M-J-Bauer/REMI-3-all-in-one-EWI/doc/REMI-3_proto1_dimensions.jpg

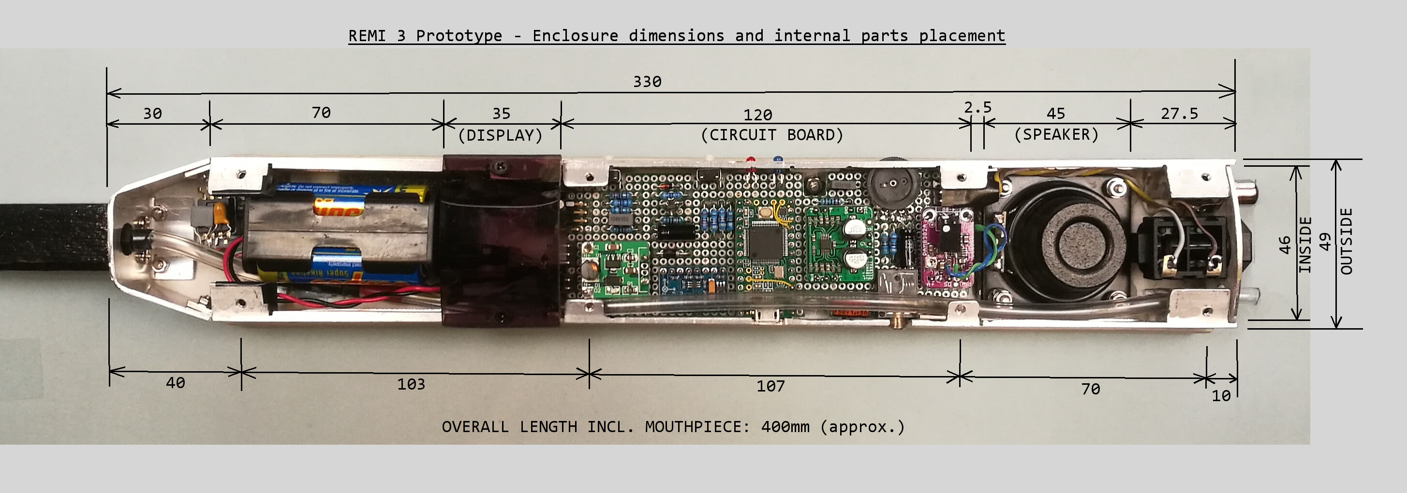
doc/REMI-3_proto1_dimensions.jpg
