M-J-Bauer/REMI-3-all-in-one-EWI/doc/REMI-3-cct-board-schematic-v1.1.pdf

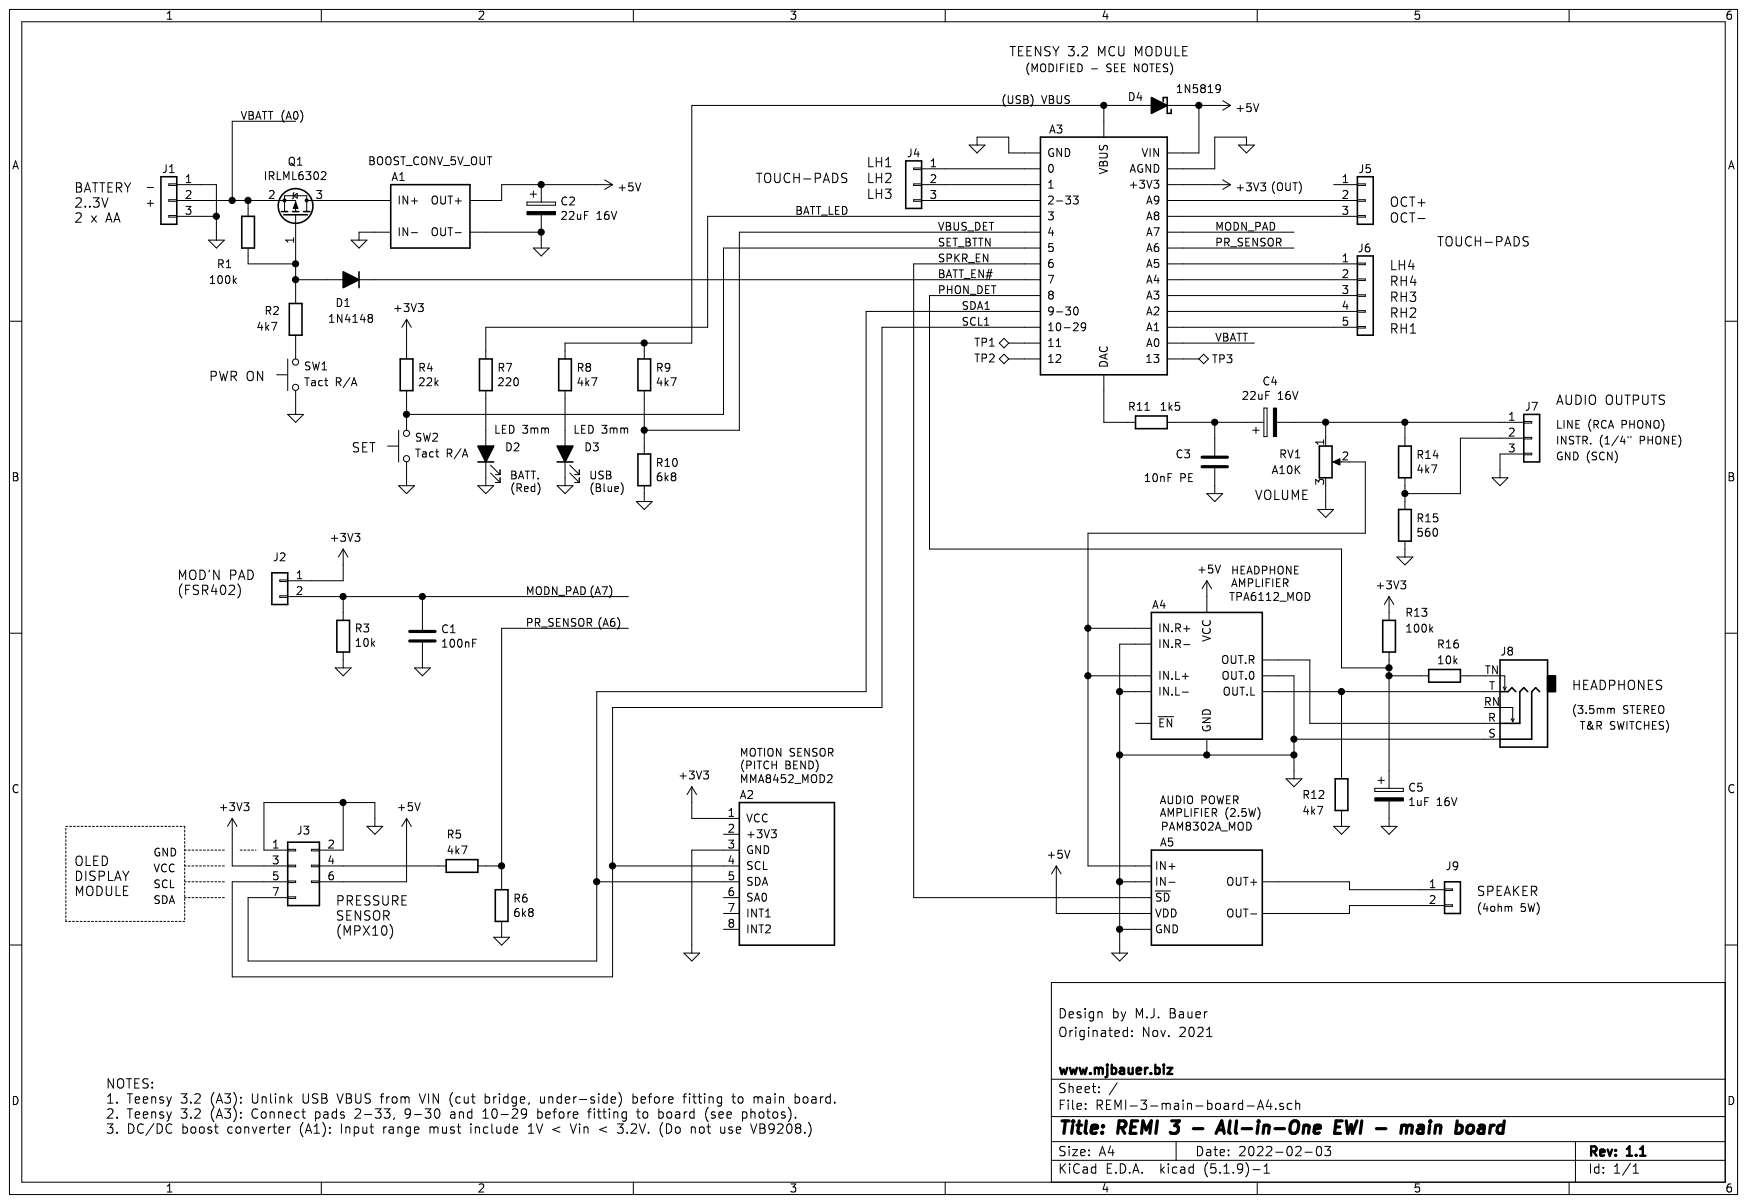
[picture p12: page 1]
