M-J-Bauer/REMI-3-all-in-one-EWI/remi_3_synth_data.ino

/*
 * Module:       remi_synth2_data.c
 *
 * Overview:     Patch parameter tables and waveform definitions.
 *
 * ================================================================================================
 */
#include "remi_3_synth.h"


// Pre-defined Patch "Programs" -- Array of patch parameter tables in flash memory
// ```````````````````````````````````````````````````````````````````````````````
const  PatchParamTable_t  g_PatchProgram[] =
{
    //--------  R E C O R D E R S,  F L U T E S   &   P I P E S  ---------
    {
        10,     // Patch ID Number
        "Recorder",
        13,     // W1: OSC1 Wave-table ID (0..99) = recorder_alto
        13,     // W2: OSC2 Wave-table ID (0..99) = recorder_alto
        0,      // OD: OSC2 Detune, cents (+/-1200)
        50,     // LF: LFO Freq x10 Hz (1..250)
        50,     // VD: Vibrato Depth, cents (0..200)
        500,    // VR: Vibrato Ramp time, (5..5000+ ms)

        0,      // MC: Mixer Control (0:Fixed, 1:Contour, 2:LFO, 3:Exprn, 4:Modn)
        0,      // ML: Mixer OSC2 Level in Fixed mode (0..100 %)
        0,      // CS: Contour Env Start level (0..100 %)
        0,      // CD: Contour Env Delay time (5..5000+ ms)
        200,    // CR: Contour Env Ramp time (5..5000+ ms)
        80,     // CH: Contour Env Hold level (0..100 %)
        
        0,      // NM: Noise Mode (0:Off, 1:Noise, 2:Add wave, 3:Mix wave; +4:Pitch)
        0,      // NC: Noise Level Ctrl (0:Fixed, 1:Ampld.Env, 2:LFO, 3:Exprn, 4:Modn)
        0,      // FC: Filter Control (0:Fixed, 1:Contour, 2:LFO, 3:Exprn, 4:Modn)
        0,      // FR: Filter Resonance x10000 (0..9990, 0:Bypass)
        0,      // FF: Filter Freq/Offset (semitone#, 0..108)
        0,      // FT: Filter Note Tracking (0:Off, 1:On)
                
        10,     // EA: Envelope Attack time (5..5000+ ms)
        0,      // EP: Envelope Peak time (0..5000+ ms)
        10,     // ED: Envelope Decay time (5..5000+ ms)
        100,    // ER: Envelope Release time (5..5000+ ms)
        90,     // ES: Envelope Sustain level (0..100 %)
        100,    // AL: Audio Level Adjust (10..250 %)
    },
    
    {
        11,     // Patch ID Number
        "Recorder celeste",
        2,      // W1: OSC1 Wave-table ID (0..99) = square_wave
        13,     // W2: OSC2 Wave-table ID (0..99) = recorder_alto
        -3,     // OD: OSC2 Detune, cents (+/-1200)
        50,     // LF: LFO Freq x10 Hz (1..250)
        20,     // VD: Vibrato Depth, cents (0..200)
        500,    // VR: Vibrato Ramp time, (5..5000+ ms)

        0,      // MC: Mixer Control (0:Fixed, 1:Contour, 2:LFO, 3:Exprn, 4:Modn)
        30,     // ML: Mixer OSC2 Level in Fixed mode (0..100 %)
        0,      // CS: Contour Env Start level (0..100 %)
        0,      // CD: Contour Env Delay time (5..5000+ ms)
        200,    // CR: Contour Env Ramp time (5..5000+ ms)
        80,     // CH: Contour Env Hold level (0..100 %)
        
        0,      // NM: Noise Mode (0:Off, 1:Noise, 2:Add wave, 3:Mix wave; +4:Pitch)
        0,      // NC: Noise Level Ctrl (0:Fixed, 1:Ampld.Env, 2:LFO, 3:Exprn, 4:Modn)
        0,      // FC: Filter Control (0:Fixed, 1:Contour, 2:LFO, 3:Exprn, 4:Modn)
        0,      // FR: Filter Resonance x10000 (0..9990, 0:Bypass)
        0,      // FF: Filter Freq/Offset (semitone#, 0..108)
        0,      // FT: Filter Note Tracking (0:Off, 1:On)
                
        10,     // EA: Envelope Attack time (5..5000+ ms)
        0,      // EP: Envelope Peak time (0..5000+ ms)
        10,     // ED: Envelope Decay time (5..5000+ ms)
        100,    // ER: Envelope Release time (5..5000+ ms)
        90,     // ES: Envelope Sustain level (0..100 %)
        100,    // AL: Audio Level Adjust (10..250 %)
    },    

    {
        12,     // Patch ID Number
        "Clean Bright Flute",
        6,      // W1: OSC1 Wave-table ID (0..99)
        6,      // W2: OSC2 Wave-table ID (0..99)
        0,      // OD: OSC2 Detune, cents (+/-1200)
        50,     // LF: LFO Freq x10 Hz (1..250)
        50,     // VD: Vibrato Depth, cents (0..200)
        500,    // VR: Vibrato Ramp time, (5..5000+ ms)

        0,      // MC: Mixer Control (0:Fixed, 1:Contour, 2:LFO, 3:Exprn, 4:Modn)
        0,      // ML: Mixer OSC2 Level in Fixed mode (0..100 %)
        0,      // CS: Contour Env Start level (0..100 %)
        0,      // CD: Contour Env Delay time (5..5000+ ms)
        200,    // CR: Contour Env Ramp time (5..5000+ ms)
        80,     // CH: Contour Env Hold level (0..100 %)
        
        0,      // NM: Noise Mode (0:Off, 1:Noise, 2:Add wave, 3:Mix wave; +4:Pitch)
        0,      // NC: Noise Level Ctrl (0:Fixed, 1:Ampld.Env, 2:LFO, 3:Exprn, 4:Modn)
        0,      // FC: Filter Control (0:Fixed, 1:Contour, 2:LFO, 3:Exprn, 4:Modn)
        0,      // FR: Filter Resonance x10000 (0..9990, 0:Bypass)
        0,      // FF: Filter Freq/Offset (semitone#, 0..108)
        0,      // FT: Filter Note Tracking (0:Off, 1:On)
                
        10,     // EA: Envelope Attack time (5..5000+ ms)
        0,      // EP: Envelope Peak time (0..5000+ ms)
        10,     // ED: Envelope Decay time (5..5000+ ms)
        100,    // ER: Envelope Release time (5..5000+ ms)
        90,     // ES: Envelope Sustain level (0..100 %)
        100,    // AL: Audio Level Adjust (10..250 %)
    },
    
    {
        13,     // Patch ID Number
        "Mellow Pipe",
        12,     // W1: OSC1 Wave-table ID (0..99)
        12,     // W2: OSC2 Wave-table ID (0..99)
        -3,     // OD: OSC2 Detune, cents (+/-1200)
        50,     // LF: LFO Freq x10 Hz (1..250)
        30,     // VD: Vibrato Depth, cents (0..200)
        500,    // VR: Vibrato Ramp time, (5..5000+ ms)

        0,      // MC: Mixer Control (0:Fixed, 1:Contour, 2:LFO, 3:Exprn, 4:Modn)
        20,     // ML: Mixer OSC2 Level in Fixed mode (0..100 %)
        0,      // CS: Contour Env Start level (0..100 %)
        0,      // CD: Contour Env Delay time (5..5000+ ms)
        200,    // CR: Contour Env Ramp time (5..5000+ ms)
        80,     // CH: Contour Env Hold level (0..100 %)
        
        0,      // NM: Noise Mode (0:Off, 1:Noise, 2:Add wave, 3:Mix wave; +4:Pitch)
        0,      // NC: Noise Level Ctrl (0:Fixed, 1:Ampld.Env, 2:LFO, 3:Exprn, 4:Modn)
        0,      // FC: Filter Control (0:Fixed, 1:Contour, 2:LFO, 3:Exprn, 4:Modn)
        0,      // FR: Filter Resonance x10000 (0..9990, 0:Bypass)
        0,      // FF: Filter Freq/Offset (semitone#, 0..108)
        0,      // FT: Filter Note Tracking (0:Off, 1:On)
                
        10,     // EA: Envelope Attack time (5..5000+ ms)
        0,      // EP: Envelope Peak time (0..5000+ ms)
        10,     // ED: Envelope Decay time (5..5000+ ms)
        100,    // ER: Envelope Release time (5..5000+ ms)
        90,     // ES: Envelope Sustain level (0..100 %)
        100,    // AL: Audio Level Adjust (10..250 %)
    },

    //---------------  R E E D E D   W O O D W I N D S  --------------------
    {
        21,     // Patch ID Number
        "Reeded Woodwind",  // Breath-controlled wave morph... sax-like
        2,      // W1: OSC1 Wave-table ID (0..99)
        9,      // W2: OSC2 Wave-table ID (0..99)
        -3,     // OD: OSC2 Detune, cents (+/-1200)
        50,     // LF: LFO Freq x10 Hz (1..250)
        30,     // VD: Vibrato Depth, cents (0..200)
        500,    // VR: Vibrato Ramp time (5..5000+ ms)

        3,      // MC: Mixer Control (0:Fixed, 1:Contour, 2:LFO, 3:Exprn, 4:Modn)
        0,      // ML: Mixer OSC2 Level in Fixed mode (0..100 %)
        80,     // CS: Contour Env Start level (0..100 %)
        5,      // CD: Contour Env Delay time (5..5000+ ms)
        500,    // CR: Contour Env Ramp time (5..5000+ ms)
        50,     // CH: Contour Env Hold level (0..100 %)

        0,      // NM: Noise Mode (0:Off, 1:Noise, 2:Add wave, 3:Mix wave; +4:Pitch)
        0,      // NC: Noise Level Ctrl (0:Fixed, 1:Ampld.Env, 2:LFO, 3:Exprn, 4:Modn)
        0,      // FC: Filter Ctrl (0:Fixed, 1:Contour, 2:Env+, 3:Env-, 4:LFO, 5:Modn)
        9700,   // FR: Filter Resonance x10000  (0..9990, 0:Bypass)
        15,     // FF: Filter Freq/Offset (semitone#, 0..108)
        1,      // FT: Filter Note Tracking (0:Off, 1:On)

        20,     // EA: Envelope Attack time (5..5000+ ms)
        0,      // EP: Envelope Peak time (0..5000+ ms)
        10,     // ED: Envelope Decay time (5..5000+ ms)
        100,    // ER: Envelope Release time (5..5000+ ms)
        90,     // ES: Envelope Sustain level (0..100 %)
        100,    // AL: Audio Level Adjust (10..250 %)
    },
    
    {
        23,     // Patch ID Number
        "Saxophoney",  // Sounds too simple... Needs work !!!  ***********************************
        9,      // W1: OSC1 Wave-table ID (0..99)
        9,      // W2: OSC2 Wave-table ID (0..99)
        0,      // OD: OSC2 Detune, cents (+/-1200)
        50,     // LF: LFO Freq x10 Hz (1..250)
        30,     // VD: Vibrato Depth, cents (0..200)
        500,    // VR: Vibrato Ramp time, (5..5000+ ms)

        0,      // MC: Mixer Control (0:Fixed, 1:Contour, 2:LFO, 3:Exprn, 4:Modn)
        0,      // ML: Mixer OSC2 Level in Fixed mode (0..100 %)
        0,      // CS: Contour Env Start level (0..100 %)
        0,      // CD: Contour Env Delay time (5..5000+ ms)
        200,    // CR: Contour Env Ramp time (5..5000+ ms)
        80,     // CH: Contour Env Hold level (0..100 %)
        
        0,      // NM: Noise Mode (0:Off, 1:Noise, 2:Add wave, 3:Mix wave; +4:Pitch)
        0,      // NC: Noise Level Ctrl (0:Fixed, 1:Ampld.Env, 2:LFO, 3:Exprn, 4:Modn)
        0,      // FC: Filter Control (0:Fixed, 1:Contour, 2:LFO, 3:Exprn, 4:Modn)
        0,      // FR: Filter Resonance x10000 (0..9990, 0:Bypass)
        0,      // FF: Filter Freq/Offset (semitone#, 0..108)
        0,      // FT: Filter Note Tracking (0:Off, 1:On)
                
        20,     // EA: Envelope Attack time (5..5000+ ms)
        0,      // EP: Envelope Peak time (0..5000+ ms)
        10,     // ED: Envelope Decay time (5..5000+ ms)
        100,    // ER: Envelope Release time (5..5000+ ms)
        90,     // ES: Envelope Sustain level (0..100 %)
        100,    // AL: Audio Level Adjust (10..250 %)
    },

    {
        24,     // Patch ID Number
        "Mellow Reed",
        23,     // W1: OSC1 Wave-table ID (0..99)
        23,     // W2: OSC2 Wave-table ID (0..99)
        -3,     // OD: OSC2 Detune, cents (+/-1200)
        50,     // LF: LFO Freq x10 Hz (1..250)
        30,     // VD: Vibrato Depth, cents (0..200)
        500,    // VR: Vibrato Ramp time, (5..5000+ ms)

        0,      // MC: Mixer Control (0:Fixed, 1:Contour, 2:LFO, 3:Exprn, 4:Modn)
        20,     // ML: Mixer OSC2 Level in Fixed mode (0..100 %)
        0,      // CS: Contour Env Start level (0..100 %)
        0,      // CD: Contour Env Delay time (5..5000+ ms)
        200,    // CR: Contour Env Ramp time (5..5000+ ms)
        80,     // CH: Contour Env Hold level (0..100 %)
        
        0,      // NM: Noise Mode (0:Off, 1:Noise, 2:Add wave, 3:Mix wave; +4:Pitch)
        0,      // NC: Noise Level Ctrl (0:Fixed, 1:Ampld.Env, 2:LFO, 3:Exprn, 4:Modn)
        0,      // FC: Filter Control (0:Fixed, 1:Contour, 2:LFO, 3:Exprn, 4:Modn)
        0,      // FR: Filter Resonance x10000 (0..9990, 0:Bypass)
        0,      // FF: Filter Freq/Offset (semitone#, 0..108)
        0,      // FT: Filter Note Tracking (0:Off, 1:On)
                
        10,     // EA: Envelope Attack time (5..5000+ ms)
        0,      // EP: Envelope Peak time (0..5000+ ms)
        10,     // ED: Envelope Decay time (5..5000+ ms)
        100,    // ER: Envelope Release time (5..5000+ ms)
        90,     // ES: Envelope Sustain level (0..100 %)
        100,    // AL: Audio Level Adjust (10..250 %)
    },

    {
        25,     // Patch ID Number   
        "Psychedelic Oboe",
        9,      // W1: OSC1 Wave-table ID (0..99)
        10,     // W2: OSC2 Wave-table ID (0..99)
        -7,     // OD: OSC2 Detune, cents (+/-1200)
        50,     // LF: LFO Freq x10 Hz (1..250)
        30,     // VD: Vibrato Depth, cents (0..200)
        300,    // VR: Vibrato Ramp time, (5..5000+ ms)

        3,      // MC: Mixer Control (0:Fixed, 1:Contour, 2:LFO, 3:Exprn, 4:Modn)
        50,     // ML: Mixer OSC2 Level in Fixed mode (0..100 %)
        10,     // CS: Contour Env Start level (0..100 %)
        50,     // CD: Contour Env Delay time (5..5000+ ms)
        500,    // CR: Contour Env Ramp time (5..5000+ ms)
        80,     // CH: Contour Env Hold level (0..100 %)
        
        0,      // NM: Noise Mode (0:Off, 1:Noise, 2:Add wave, 3:Mix wave; +4:Pitch)
        0,      // NC: Noise Level Ctrl (0:Fixed, 1:Ampld.Env, 2:LFO, 3:Exprn, 4:Modn)
        0,      // FC: Filter Control (0:Fixed, 1:Contour, 2:LFO, 3:Exprn, 4:Modn)
        0,      // FR: Filter Resonance x10000 (0..9990, 0:Bypass)
        0,      // FF: Filter Freq/Offset (semitone#, 0..108)
        0,      // FT: Filter Note Tracking (0:Off, 1:On)
                
        20,     // EA: Envelope Attack time (5..5000+ ms)
        0,      // EP: Envelope Peak time (0..5000+ ms)
        10,     // ED: Envelope Decay time (5..5000+ ms)
        100,    // ER: Envelope Release time (5..5000+ ms)
        90,     // ES: Envelope Sustain level (0..100 %)
        100,    // AL: Audio Level Adjust (10..250 %)
    },

    {
        26,     // Patch ID Number  
        "Electric Clarinet",  
        12,     // W1: OSC1 Wave-table ID (0..99)
        11,     // W2: OSC2 Wave-table ID (0..99)
        3,      // OD: OSC2 Detune, cents (+/-1200)
        50,     // LF: LFO Freq x10 Hz (1..250)
        30,     // VD: Vibrato Depth, cents (0..200)
        500,    // VR: Vibrato Ramp time, (5..5000+ ms)

        3,      // MC: Mixer Control (0:Fixed, 1:Contour, 2:LFO, 3:Exprn, 4:Modn)
        50,     // ML: Mixer OSC2 Level in Fixed mode (0..100 %)
        0,      // CS: Contour Env Start level (0..100 %)
        0,      // CD: Contour Env Delay time (5..5000+ ms)
        200,    // CR: Contour Env Ramp time (5..5000+ ms)
        100,    // CH: Contour Env Hold level (0..100 %)
        
        0,      // NM: Noise Mode (0:Off, 1:Noise, 2:Add wave, 3:Mix wave; +4:Pitch)
        0,      // NC: Noise Level Ctrl (0:Fixed, 1:Ampld.Env, 2:LFO, 3:Exprn, 4:Modn)
        0,      // FC: Filter Control (0:Fixed, 1:Contour, 2:LFO, 3:Exprn, 4:Modn)
        9700,   // FR: Filter Resonance x10000 (0..9990, 0:Bypass)
        9,      // FF: Filter Freq/Offset (semitone#, 0..108)
        1,      // FT: Filter Note Tracking (0:Off, 1:On)
                
        20,     // EA: Envelope Attack time (5..5000+ ms)
        0,      // EP: Envelope Peak time (0..5000+ ms)
        10,     // ED: Envelope Decay time (5..5000+ ms)
        100,    // ER: Envelope Release time (5..5000+ ms)
        90,     // ES: Envelope Sustain level (0..100 %)
        100,    // AL: Audio Level Adjust (10..250 %)
    },
    
    //----------------  B O W E D   S T R I N G   I N S T R U M E N T S  ------------
    {
        30,     // Patch ID Number
        "Vinyl-cello",
        3,      // W1: OSC1 Wave-table ID (0..99) 
        3,      // W2: OSC2 Wave-table ID (0..99)   
        3,      // OD: OSC2 Detune, cents (+/-1200)
        50,     // LF: LFO Freq x10 Hz (1..250)
        30,     // VD: Vibrato Depth, cents (0..200)
        300,    // VR: Vibrato Ramp time, (5..5000+ ms)

        1,      // MC: Mixer Control (0:Fixed, 1:Contour, 2:LFO, 3:Exprn, 4:Modn)
        50,     // ML: Mixer OSC2 Level in Fixed mode (0..100 %)
        20,     // CS: Contour Env Start level (0..100 %)
        10,     // CD: Contour Env Delay time (5..5000+ ms)
        200,    // CR: Contour Env Ramp time (5..5000+ ms)
        80,     // CH: Contour Env Hold level (0..100 %)
        
        0,      // NM: Noise Mode (0:Off, 1:Noise, 2:Add wave, 3:Mix wave; +4:Pitch)
        0,      // NC: Noise Level Ctrl (0:Fixed, 1:Ampld.Env, 2:LFO, 3:Exprn, 4:Modn)
        0,      // FC: Filter Control (0:Fixed, 1:Contour, 2:LFO, 3:Exprn, 4:Modn)
        9500,   // FR: Filter Resonance x10000  (0..9990, 0:Bypass)
        60,     // FF: Filter Freq/Offset (semitone#, 0..108)
        0,      // FT: Filter Note Tracking (0:Off, 1:On)
                
        30,     // EA: Envelope Attack time (5..5000+ ms)
        0,      // EP: Envelope Peak time (0..5000+ ms)
        10,     // ED: Envelope Decay time (5..5000+ ms)
        10,     // ER: Envelope Release time (5..5000+ ms)
        90,     // ES: Envelope Sustain level (0..100 %)
        100,    // AL: Audio Level Adjust (10..250 %)
    },

    //------------------  O R G A N S   &  A C C O R D I O N  -----------------
    {
        40,     // Patch ID Number
        "Jazz Organ celeste",  // Experiment with wave-tables  **************************
        14,     // W1: OSC1 Wave-table ID (0..99) = jazz_organ_v1
        14,     // W2: OSC2 Wave-table ID (0..99) = jazz_organ_v1
        -6,     // OD: OSC2 Detune, cents (+/-1200)
        50,     // LF: LFO Freq x10 Hz (1..250)
        30,     // VD: Vibrato Depth, cents (0..200)
        500,    // VR: Vibrato Ramp time, (5..5000+ ms)

        0,      // MC: Mixer Control (0:Fixed, 1:Contour, 2:LFO, 3:Exprn, 4:Modn)
        30,     // ML: Mixer OSC2 Level in Fixed mode (0..100 %)
        0,      // CS: Contour Env Start level (0..100 %)
        0,      // CD: Contour Env Delay time (5..5000+ ms)
        200,    // CR: Contour Env Ramp time (5..5000+ ms)
        80,     // CH: Contour Env Hold level (0..100 %)
        
        0,      // NM: Noise Mode (0:Off, 1:Noise, 2:Add wave, 3:Mix wave; +4:Pitch)
        0,      // NC: Noise Level Ctrl (0:Fixed, 1:Ampld.Env, 2:LFO, 3:Exprn, 4:Modn)
        0,      // FC: Filter Control (0:Fixed, 1:Contour, 2:LFO, 3:Exprn, 4:Modn)
        0,      // FR: Filter Resonance x10000 (0..9990, 0:Bypass)
        0,      // FF: Filter Freq/Offset (semitone#, 0..108)
        0,      // FT: Filter Note Tracking (0:Off, 1:On)
                
        5,      // EA: Envelope Attack time (5..5000+ ms)
        0,      // EP: Envelope Peak time (0..5000+ ms)
        5,      // ED: Envelope Decay time (5..5000+ ms)
        10,     // ER: Envelope Release time (5..5000+ ms)
        80,     // ES: Envelope Sustain level (0..100 %)
        100,    // AL: Audio Level Adjust (10..250 %)
    },
    
    {
        41,     // Patch ID Number
        "Jazz-Rock Organ 1",  // Classic Hammond rock organ tone.  Slightly percussive.
        17,     // W1: OSC1 Wave-table ID (0..99)   
        17,     // W2: OSC2 Wave-table ID (0..99) 
        0,      // OD: OSC2 Detune, cents (+/-1200)
        70,     // LF: LFO Freq x10 Hz (1..250)
        30,     // VD: Vibrato Depth, cents (0..200)
        500,    // VR: Vibrato Ramp time, (5..5000+ ms)

        0,      // MC: Mixer Control (0:Fixed, 1:Contour, 2:LFO, 3:Exprn, 4:Modn)
        50,     // ML: Mixer OSC2 Level in Fixed mode (0..100 %)
        0,      // CS: Contour Env Start level (0..100 %)
        0,      // CD: Contour Env Delay time (5..5000+ ms)
        200,    // CR: Contour Env Ramp time (5..5000+ ms)
        80,     // CH: Contour Env Hold level (0..100 %)
        
        0,      // NM: Noise Mode (0:Off, 1:Noise, 2:Add wave, 3:Mix wave; +4:Pitch)
        0,      // NC: Noise Level Ctrl (0:Fixed, 1:Ampld.Env, 2:LFO, 3:Exprn, 4:Modn)
        0,      // FC: Filter Control (0:Fixed, 1:Contour, 2:LFO, 3:Exprn, 4:Modn)
        0,      // FR: Filter Resonance x10000 (0..9990, 0:Bypass)
        0,      // FF: Filter Freq/Offset (semitone#, 0..108)
        0,      // FT: Filter Note Tracking (0:Off, 1:On)
                
        5,      // EA: Envelope Attack time (5..5000+ ms)
        50,     // EP: Envelope Peak time (0..5000+ ms)
        100,    // ED: Envelope Decay time (5..5000+ ms)
        50,     // ER: Envelope Release time (5..5000+ ms)
        70,     // ES: Envelope Sustain level (0..100 %)
        100,    // AL: Audio Level Adjust (10..250 %)
    },

    {
        42,     // Patch ID Number
        "Jazz-Rock Organ 2",  // Classic Hammond rock organ tone.  Slightly percussive.
        18,     // W1: OSC1 Wave-table ID (0..99)   
        18,     // W2: OSC2 Wave-table ID (0..99)   
        0,      // OD: OSC2 Detune, cents (+/-1200)
        70,     // LF: LFO Freq x10 Hz (1..250)
        30,     // VD: Vibrato Depth, cents (0..200)
        500,    // VR: Vibrato Ramp time, (5..5000+ ms)

        0,      // MC: Mixer Control (0:Fixed, 1:Contour, 2:LFO, 3:Exprn, 4:Modn)
        25,     // ML: Mixer OSC2 Level in Fixed mode (0..100 %)
        0,      // CS: Contour Env Start level (0..100 %)
        0,      // CD: Contour Env Delay time (5..5000+ ms)
        200,    // CR: Contour Env Ramp time (5..5000+ ms)
        80,     // CH: Contour Env Hold level (0..100 %)
        
        0,      // NM: Noise Mode (0:Off, 1:Noise, 2:Add wave, 3:Mix wave; +4:Pitch)
        0,      // NC: Noise Level Ctrl (0:Fixed, 1:Ampld.Env, 2:LFO, 3:Exprn, 4:Modn)
        0,      // FC: Filter Control (0:Fixed, 1:Contour, 2:LFO, 3:Exprn, 4:Modn)
        0,      // FR: Filter Resonance x10000 (0..9990, 0:Bypass)
        0,      // FF: Filter Freq/Offset (semitone#, 0..108)
        0,      // FT: Filter Note Tracking (0:Off, 1:On)
                
        5,      // EA: Envelope Attack time (5..5000+ ms)
        50,     // EP: Envelope Peak time (0..5000+ ms)
        100,    // ED: Envelope Decay time (5..5000+ ms)
        50,     // ER: Envelope Release time (5..5000+ ms)
        70,     // ES: Envelope Sustain level (0..100 %)
        100,    // AL: Audio Level Adjust (10..250 %)
    },
    
    {
        43,     // Patch ID Number
        "Jazz-Rock Organ 3",  // Classic Hammond rock organ tone.  Slightly percussive.
        14,     // W1: OSC1 Wave-table ID (0..99)   
        14,     // W2: OSC2 Wave-table ID (0..99)   
        -5,     // OD: OSC2 Detune, cents (+/-1200)
        70,     // LF: LFO Freq x10 Hz (1..250)
        30,     // VD: Vibrato Depth, cents (0..200)
        500,    // VR: Vibrato Ramp time, (5..5000+ ms)

        0,      // MC: Mixer Control (0:Fixed, 1:Contour, 2:LFO, 3:Exprn, 4:Modn)
        25,     // ML: Mixer OSC2 Level in Fixed mode (0..100 %)
        0,      // CS: Contour Env Start level (0..100 %)
        0,      // CD: Contour Env Delay time (5..5000+ ms)
        200,    // CR: Contour Env Ramp time (5..5000+ ms)
        80,     // CH: Contour Env Hold level (0..100 %)
        
        0,      // NM: Noise Mode (0:Off, 1:Noise, 2:Add wave, 3:Mix wave; +4:Pitch)
        0,      // NC: Noise Level Ctrl (0:Fixed, 1:Ampld.Env, 2:LFO, 3:Exprn, 4:Modn)
        0,      // FC: Filter Control (0:Fixed, 1:Contour, 2:LFO, 3:Exprn, 4:Modn)
        0,      // FR: Filter Resonance x10000 (0..9990, 0:Bypass)
        0,      // FF: Filter Freq/Offset (semitone#, 0..108)
        0,      // FT: Filter Note Tracking (0:Off, 1:On)
                
        5,      // EA: Envelope Attack time (5..5000+ ms)
        50,     // EP: Envelope Peak time (0..5000+ ms)
        100,    // ED: Envelope Decay time (5..5000+ ms)
        50,     // ER: Envelope Release time (5..5000+ ms)
        70,     // ES: Envelope Sustain level (0..100 %)
        100,    // AL: Audio Level Adjust (10..250 %)
    },
    
    {
        44,     // Patch ID Number
        "Theatre Organ",  // "All stops out" -- rich & deep harmonic content
        21,     // W1: OSC1 Wave-table ID (0..99)   
        21,     // W2: OSC2 Wave-table ID (0..99)   
        -5,     // OD: OSC2 Detune, cents (+/-1200)
        70,     // LF: LFO Freq x10 Hz (1..250)
        30,     // VD: Vibrato Depth, cents (0..200)
        500,    // VR: Vibrato Ramp time, (5..5000+ ms)

        0,      // MC: Mixer Control (0:Fixed, 1:Contour, 2:LFO, 3:Exprn, 4:Modn)
        20,     // ML: Mixer OSC2 Level in Fixed mode (0..100 %)
        0,      // CS: Contour Env Start level (0..100 %)
        0,      // CD: Contour Env Delay time (5..5000+ ms)
        200,    // CR: Contour Env Ramp time (5..5000+ ms)
        80,     // CH: Contour Env Hold level (0..100 %)
        
        0,      // NM: Noise Mode (0:Off, 1:Noise, 2:Add wave, 3:Mix wave; +4:Pitch)
        0,      // NC: Noise Level Ctrl (0:Fixed, 1:Ampld.Env, 2:LFO, 3:Exprn, 4:Modn)
        0,      // FC: Filter Control (0:Fixed, 1:Contour, 2:LFO, 3:Exprn, 4:Modn)
        0,      // FR: Filter Resonance x10000 (0..9990, 0:Bypass)
        0,      // FF: Filter Freq/Offset (semitone#, 0..108)
        0,      // FT: Filter Note Tracking (0:Off, 1:On)
                
        5,      // EA: Envelope Attack time (5..5000+ ms)
        0,      // EP: Envelope Peak time (0..5000+ ms)
        5,      // ED: Envelope Decay time (5..5000+ ms)
        10,     // ER: Envelope Release time (5..5000+ ms)
        90,     // ES: Envelope Sustain level (0..100 %)
        100,    // AL: Audio Level Adjust (10..250 %)
    },
    
    {
        45,     // Patch ID Number
        "Pink Floyd Organ",  // Essential Preset Patch! -- complex etherial flutey tone
        20,     // W1: OSC1 Wave-table ID (0..99)   
        20,     // W2: OSC2 Wave-table ID (0..99)   
        -5,     // OD: OSC2 Detune, cents (+/-1200)
        70,     // LF: LFO Freq x10 Hz (1..250)
        30,     // VD: Vibrato Depth, cents (0..200)
        500,    // VR: Vibrato Ramp time, (5..5000+ ms)

        0,      // MC: Mixer Control (0:Fixed, 1:Contour, 2:LFO, 3:Exprn, 4:Modn)
        50,     // ML: Mixer OSC2 Level in Fixed mode (0..100 %)
        0,      // CS: Contour Env Start level (0..100 %)
        0,      // CD: Contour Env Delay time (5..5000+ ms)
        200,    // CR: Contour Env Ramp time (5..5000+ ms)
        80,     // CH: Contour Env Hold level (0..100 %)
        
        0,      // NM: Noise Mode (0:Off, 1:Noise, 2:Add wave, 3:Mix wave; +4:Pitch)
        0,      // NC: Noise Level Ctrl (0:Fixed, 1:Ampld.Env, 2:LFO, 3:Exprn, 4:Modn)
        0,      // FC: Filter Control (0:Fixed, 1:Contour, 2:LFO, 3:Exprn, 4:Modn)
        0,      // FR: Filter Resonance x10000 (0..9990, 0:Bypass)
        0,      // FF: Filter Freq/Offset (semitone#, 0..108)
        0,      // FT: Filter Note Tracking (0:Off, 1:On)
                
        10,     // EA: Envelope Attack time (5..5000+ ms)
        50,     // EP: Envelope Peak time (0..5000+ ms)
        100,    // ED: Envelope Decay time (5..5000+ ms)
        10,     // ER: Envelope Release time (5..5000+ ms)
        70,     // ES: Envelope Sustain level (0..100 %)
        100,    // AL: Audio Level Adjust (10..250 %)
    },
    
    {
        46,     // Patch ID Number
        "Bauer Organ",  // Bright, rich tone  (experiment with detune, contour, etc)
        22,     // W1: OSC1 Wave-table ID (0..99)   
        23,     // W2: OSC2 Wave-table ID (0..99) -- experiment with morph  *************
        7,      // OD: OSC2 Detune, cents (+/-1200)
        70,     // LF: LFO Freq x10 Hz (1..250)
        30,     // VD: Vibrato Depth, cents (0..200)
        500,    // VR: Vibrato Ramp time, (5..5000+ ms)

        3,      // MC: Mixer Control (0:Fixed, 1:Contour, 2:LFO, 3:Exprn, 4:Modn)
        20,     // ML: Mixer OSC2 Level in Fixed mode (0..100 %)
        0,      // CS: Contour Env Start level (0..100 %)
        0,      // CD: Contour Env Delay time (5..5000+ ms)
        200,    // CR: Contour Env Ramp time (5..5000+ ms)
        80,     // CH: Contour Env Hold level (0..100 %)
        
        0,      // NM: Noise Mode (0:Off, 1:Noise, 2:Add wave, 3:Mix wave; +4:Pitch)
        0,      // NC: Noise Level Ctrl (0:Fixed, 1:Ampld.Env, 2:LFO, 3:Exprn, 4:Modn)
        0,      // FC: Filter Control (0:Fixed, 1:Contour, 2:LFO, 3:Exprn, 4:Modn)
        0,      // FR: Filter Resonance x10000 (0..9990, 0:Bypass)
        0,      // FF: Filter Freq/Offset (semitone#, 0..108)
        0,      // FT: Filter Note Tracking (0:Off, 1:On)
                
        10,     // EA: Envelope Attack time (5..5000+ ms)
        50,     // EP: Envelope Peak time (0..5000+ ms)
        100,    // ED: Envelope Decay time (5..5000+ ms)
        10,     // ER: Envelope Release time (5..5000+ ms)
        70,     // ES: Envelope Sustain level (0..100 %)
        100,    // AL: Audio Level Adjust (10..250 %)
    },
    
    {
        47,     // Patch ID Number
        "Hammond Organ 1",  // Classic Hammond organ tone.  Slightly percussive.
        15,     // W1: OSC1 Wave-table ID (0..99)   
        15,     // W2: OSC2 Wave-table ID (0..99)   
        -5,     // OD: OSC2 Detune, cents (+/-1200)
        70,     // LF: LFO Freq x10 Hz (1..250)
        30,     // VD: Vibrato Depth, cents (0..200)
        500,    // VR: Vibrato Ramp time, (5..5000+ ms)

        0,      // MC: Mixer Control (0:Fixed, 1:Contour, 2:LFO, 3:Exprn, 4:Modn)
        25,     // ML: Mixer OSC2 Level in Fixed mode (0..100 %)
        0,      // CS: Contour Env Start level (0..100 %)
        0,      // CD: Contour Env Delay time (5..5000+ ms)
        200,    // CR: Contour Env Ramp time (5..5000+ ms)
        80,     // CH: Contour Env Hold level (0..100 %)
        
        0,      // NM: Noise Mode (0:Off, 1:Noise, 2:Add wave, 3:Mix wave; +4:Pitch)
        0,      // NC: Noise Level Ctrl (0:Fixed, 1:Ampld.Env, 2:LFO, 3:Exprn, 4:Modn)
        0,      // FC: Filter Control (0:Fixed, 1:Contour, 2:LFO, 3:Exprn, 4:Modn)
        0,      // FR: Filter Resonance x10000 (0..9990, 0:Bypass)
        0,      // FF: Filter Freq/Offset (semitone#, 0..108)
        0,      // FT: Filter Note Tracking (0:Off, 1:On)
                
        5,      // EA: Envelope Attack time (5..5000+ ms)
        50,     // EP: Envelope Peak time (0..5000+ ms)
        100,    // ED: Envelope Decay time (5..5000+ ms)
        50,     // ER: Envelope Release time (5..5000+ ms)
        70,     // ES: Envelope Sustain level (0..100 %)
        100,    // AL: Audio Level Adjust (10..250 %)
    },
    
    {
        48,     // Patch ID Number
        "Hammond Organ 2",  // Classic Hammond organ tone.  Slightly percussive.
        16,     // W1: OSC1 Wave-table ID (0..99)   
        16,     // W2: OSC2 Wave-table ID (0..99)   
        -5,     // OD: OSC2 Detune, cents (+/-1200)
        70,     // LF: LFO Freq x10 Hz (1..250)
        30,     // VD: Vibrato Depth, cents (0..200)
        500,    // VR: Vibrato Ramp time, (5..5000+ ms)

        0,      // MC: Mixer Control (0:Fixed, 1:Contour, 2:LFO, 3:Exprn, 4:Modn)
        25,     // ML: Mixer OSC2 Level in Fixed mode (0..100 %)
        0,      // CS: Contour Env Start level (0..100 %)
        0,      // CD: Contour Env Delay time (5..5000+ ms)
        200,    // CR: Contour Env Ramp time (5..5000+ ms)
        80,     // CH: Contour Env Hold level (0..100 %)
        
        0,      // NM: Noise Mode (0:Off, 1:Noise, 2:Add wave, 3:Mix wave; +4:Pitch)
        0,      // NC: Noise Level Ctrl (0:Fixed, 1:Ampld.Env, 2:LFO, 3:Exprn, 4:Modn)
        0,      // FC: Filter Control (0:Fixed, 1:Contour, 2:LFO, 3:Exprn, 4:Modn)
        0,      // FR: Filter Resonance x10000 (0..9990, 0:Bypass)
        0,      // FF: Filter Freq/Offset (semitone#, 0..108)
        0,      // FT: Filter Note Tracking (0:Off, 1:On)
                
        5,      // EA: Envelope Attack time (5..5000+ ms)
        50,     // EP: Envelope Peak time (0..5000+ ms)
        100,    // ED: Envelope Decay time (5..5000+ ms)
        50,     // ER: Envelope Release time (5..5000+ ms)
        70,     // ES: Envelope Sustain level (0..100 %)
        100,    // AL: Audio Level Adjust (10..250 %)
    },
   
    //---------------  T E S T   &   D E M O   P A T C H E S  ------------------------
    {
        90,     // Patch ID Number
        "Test Patch (ID 90)",  // NB: Do not edit -- patch is used by diagnostics
        1,      // W1: OSC1 Wave-table ID (0..99)  <------ sinewave
        3,      // W2: OSC2 Wave-table ID (0..99)  <------ sawtooth
        0,      // OD: OSC2 Detune, cents (+/-1200)
        70,     // LF: LFO Freq x10 Hz (1..250)
        0,      // VD: Vibrato Depth, cents (0..200)
        500,    // VR: Vibrato Ramp time, (5..5000+ ms)

        0,      // MC: Mixer Control (0:Fixed, 1:Contour, 2:LFO, 3:Exprn, 4:Modn)
        0,      // ML: Mixer OSC2 Level in Fixed mode (0..100 %)
        0,      // CS: Contour Env Start level (0..100 %)
        0,      // CD: Contour Env Delay time (5..5000+ ms)
        1000,   // CR: Contour Env Ramp time (5..5000+ ms)
        100,    // CH: Contour Env Hold level (0..100 %)
        
        0,      // NM: Noise Mode (0:Off, 1:Noise, 2:Add wave, 3:Mix wave; +4:Pitch)
        0,      // NC: Noise Level Ctrl (0:Fixed, 1:Ampld.Env, 2:LFO, 3:Exprn, 4:Modn)
        0,      // FC: Filter Control (0:Fixed, 1:Contour, 2:LFO, 3:Exprn, 4:Modn)
        0,      // FR: Filter Resonance x10000 (0..9999, 0:Off/bypass)
        0,      // FF: Filter Freq/Offset (semitone#, 0..108)
        0,      // FT: Filter Note Tracking (0:Off, 1:On)
                
        50,     // EA: Envelope Attack time (5..5000+ ms)
        0,      // EP: Envelope Peak time (0..5000+ ms)
        1000,   // ED: Envelope Decay time (5..5000+ ms)
        100,    // ER: Envelope Release time (5..5000+ ms)
        80,     // ES: Envelope Sustain level (0..100 %)
        100,    // AL: Audio Level Adjust (10..250 %)
    },
	
};


// Function returns the number of Predefined Patch definitions in flash PM
//
int  GetNumberOfPatchesDefined()
{
    return  sizeof(g_PatchProgram) / sizeof(g_PatchProgram[0]);
}


// ================================================================================================
//                   F L A S H - B A S E D   W A V E - T A B L E S
/*
 * Wave-table definition ...
 * Waveform name: pure_sine_wave, size: 1260 samples
 * Osc. Freq. Divider:   1.0000
 * 
 * NB: This wave-table is also used as a general-purpose sine-wave LUT (e.g. for LFO).
 * Peak value:  +/-31,680
 */
const  int16  g_sinewave[] =
{
         0,    157,    315,    473,    631,    789,    947,   1104,   1263,   1420,
      1579,   1736,   1893,   2051,   2209,   2367,   2524,   2681,   2839,   2996,
      3154,   3310,   3467,   3625,   3781,   3938,   4095,   4252,   4408,   4564,
      4721,   4877,   5033,   5189,   5345,   5500,   5655,   5811,   5966,   6122,
      6276,   6432,   6586,   6740,   6895,   7048,   7203,   7356,   7510,   7663,
      7817,   7969,   8122,   8275,   8427,   8579,   8731,   8883,   9034,   9186,
      9337,   9488,   9638,   9789,   9939,  10089,  10238,  10388,  10537,  10686,
     10834,  10983,  11130,  11279,  11426,  11573,  11720,  11867,  12013,  12159,
     12304,  12450,  12595,  12740,  12884,  13029,  13172,  13316,  13460,  13602,
     13745,  13886,  14029,  14170,  14311,  14452,  14592,  14733,  14872,  15011,
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
//
// typedef struct Flash_Wave_Table_Descriptor
// {
//   uint16  Size;          // Table size, samples
//   float   FreqDiv;       // Osc Freq Divider
//   int16  *Address;       // Address of wave-table data
// 
// } FlashWaveTable_t;

const  FlashWaveTable_t  g_FlashWaveTableDef[] =
{
    {   // ID# 0:  <!> Reserved for RAM-based "user" wave-table
        0,
        1.00,
        (int16 *) NULL  
    },
    
    {   // ID# 1: Pure sinewave at fundamental freq.
        1260,
        1.00,
        (int16 *) g_sinewave
    },
  
    {   // ID# 2: Square wave, lightly anti-alias filtered -- classic wind pipe tone
        1260,
        1.00,
        (int16 *) square_wave 
    },
    
    {   // ID# 3: Sawtooth wave, lightly anti-alias filtered -- buzzy tone (violin/cello?)
        1260,
        1.00,
        (int16 *) sawtooth_wave 
    },

    {   // ID# 4: reserved  (formerly "rounded_square")
        1260,
        1.00,
        (int16 *) square_wave
    },
    
    {   // ID# 5: Blunt sawtooth wave -- dull, mellow sound  -- replace ??? ********************
        1260,
        1.00,
        (int16 *) blunt_sawtooth
    },
    
    {   // ID# 6: Clean bright flute -- flinty, metallic, modulated tone
        1260,
        1.00,
        (int16 *) clean_bright_flute  
    },
    
    {   // ID# 7: reserved
        1260,
        3.00,
        (int16 *) g_sinewave
    },
    
    {   // ID# 8: reserved
        1260,
        4.00,
        (int16 *) g_sinewave
    },
    
    {   // ID# 9: Alto saxophone  -- reedy, boxy sound in low register (used in patch?)
        1260,
        2.00,  // take it down an octave!
        (int16 *) alto_saxophone
    },
    
    {   // ID# 10: Psychedelic oboe -- very complex inter-modulated harmonics (nice)
        1260,
        2.00,  // take it down an octave!
        (int16 *) psychedelic_oboe
    },
    
    {   // ID# 11: Electric clarinet -- thin squeaky or boxy, depending on pitch (nice)
        1260,
        2.00,  // take it down an octave!
        (int16 *) electric_clarinet
    },
    
    {   // ID# 12: Mellow pipe #1 -- muted mellow woodwind (good - keep)
        1260,
        1.00,
        (int16 *) mellow_pipe_v1
    },
    
    {   // ID# 13: Recorder (drawbars: 00 8271 200) -- classic mostly-odd harmonic spectrum
        1260,
        2.0,
        (int16 *) recorder_008271200
    },
    
    {   // ID# 14: Rock organ 8888 (drawbars: 88 8800 000) -- simple electric organ
        1260,
        1.0,      // pitch offset = +1 octave (2x fo)
        (int16 *) hammond_rock_8888   
    },
    
    {   // ID# 15: Rock organ 8080 (drawbars: 80 8000 000) -- very mellow organ
        1260,
        2.0,
        (int16 *) hammond_rock_8080   
    },
    
    {   // ID# 16: Rock organ 0808 (drawbars: 08 0800 000) -- ring modulator effect
        1260,
        2.0,
        (int16 *) hammond_rock_0808  
    },

    {   // ID# 17: Jazz organ #1  (drawbars: 40 6160 040) 
        1260,
        2.0,  
        (int16 *) jazz_organ_406160040
    },
    
    {   // ID# 18: Jazz organ #2  (drawbars: 30 5060 040) 
        1260,
        2.0,  
        (int16 *) jazz_organ_305060040
    },
    
    {   // ID# 19: Glockenspiel (drawbars: 00 8360 400) -- timbre similar to recorder!
        1260,
        2.0, 
        (int16 *) glockenspiel_008360400
    },
    
    {   // ID# 20: Pink Floyd organ (drawbars: 85 0005 000) -- rich complex, flutey sound
        1260,
        1.00,     // pitch offset = + 1 octave (2x fo)
        (int16 *) pink_floyd_organ_850005  
    },
    
    {   // ID# 21: Theatre Organ (drawbars: 87 8656 463) -- very full organ (good)
        1260,
        2.0, 
        (int16 *) theatre_organ_878656463  
    },
    
    {   // ID# 22: BAUER organ (drawbars: 00 8008 432) -- rich, bright organ sound (keep)
        1260,
        2.00,  
        (int16 *) bauer_organ_008008432
    },
    
    {   // ID# 23: Mellow reed (drawbars: 00 8042 660) -- pleasant, rounded, oboe-ish (keep)
        1260,
        2.00,
        (int16 *) mellow_reed_008042660 
    },
/*    
    {   // ID# 24: reserved
        1260,
        2.00,  
        (int16 *) g_sinewave
    }
*/
};


// Function returns the ID number of the highest wave-table defined by the descriptor
// array g_FlashWaveTableDef[], above.  This number is an index into the array.
// Note:  Special case:  ID == 0 references the "user" wave-table buffer in RAM.
//
int  GetHighestWaveTableID()
{
    return  sizeof(g_FlashWaveTableDef) / sizeof(g_FlashWaveTableDef[0]) - 1;
}

// *** end of file ***
